cortknoxx-coder/DPA-AUP/ui-checks/device-toast.png

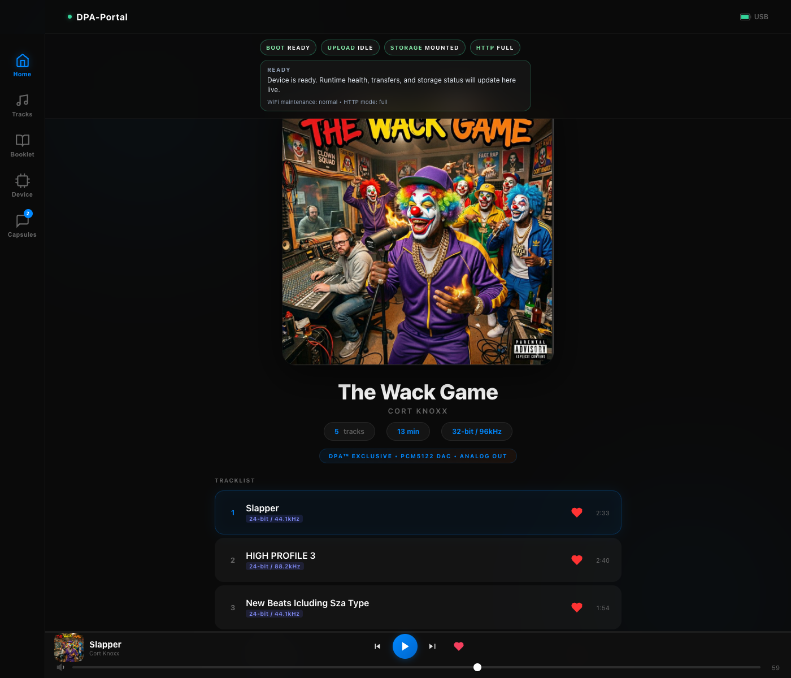
ui-checks/device-toast.png
