cortknoxx-coder/DPA-AUP/ui-checks/device-compact-hud.png

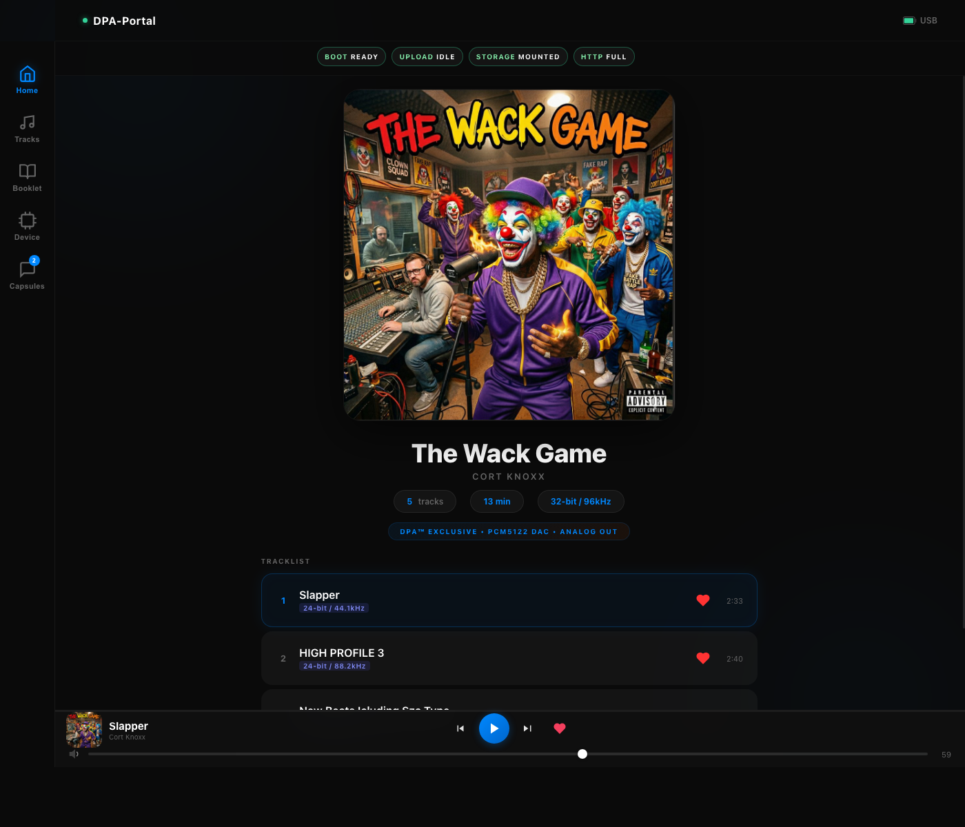
ui-checks/device-compact-hud.png
