cortknoxx-coder/DPA-AUP/ui-checks/creator-portal.png

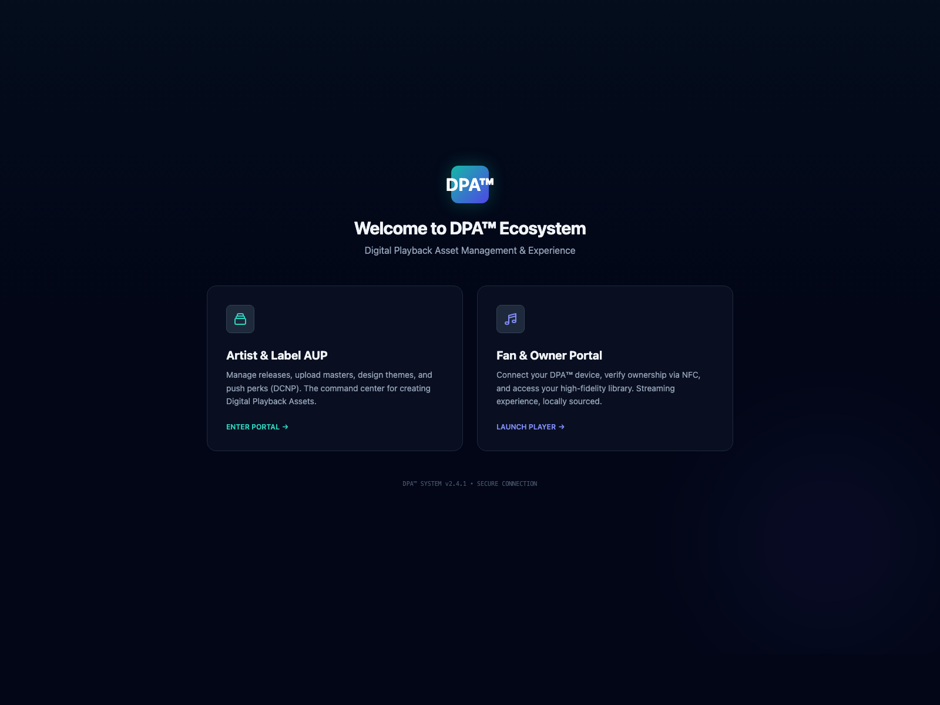
ui-checks/creator-portal.png
