cortknoxx-coder/DPA-AUP/ui-checks/creator-routed.png

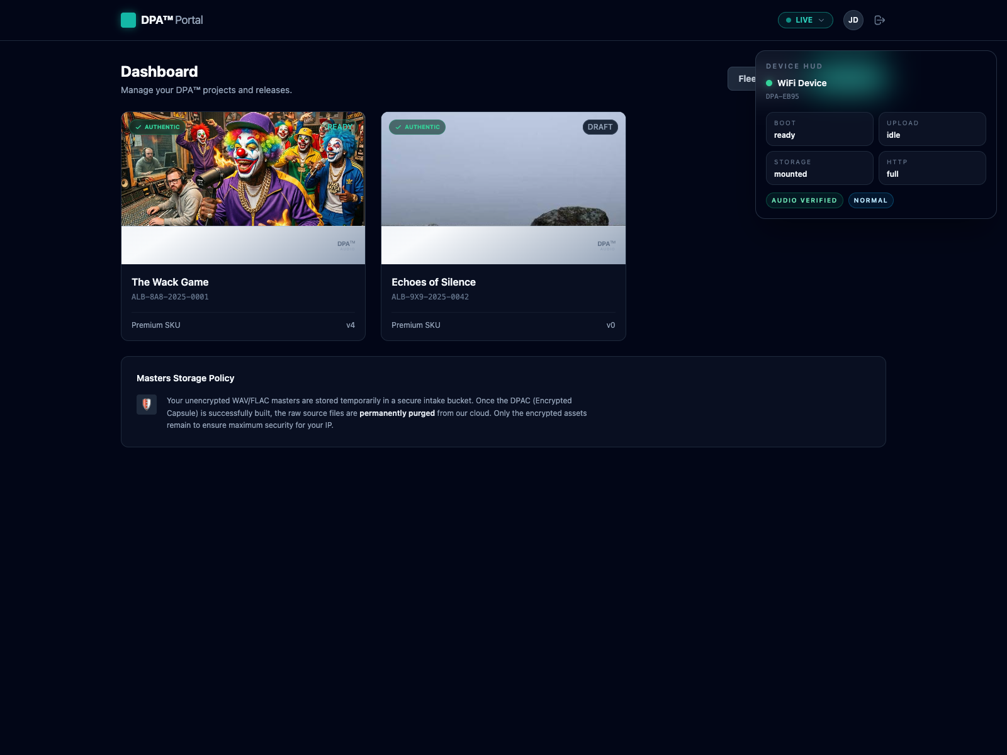
ui-checks/creator-routed.png
