cortknoxx-coder/DPA-AUP/ui-checks/device-dashboard.png

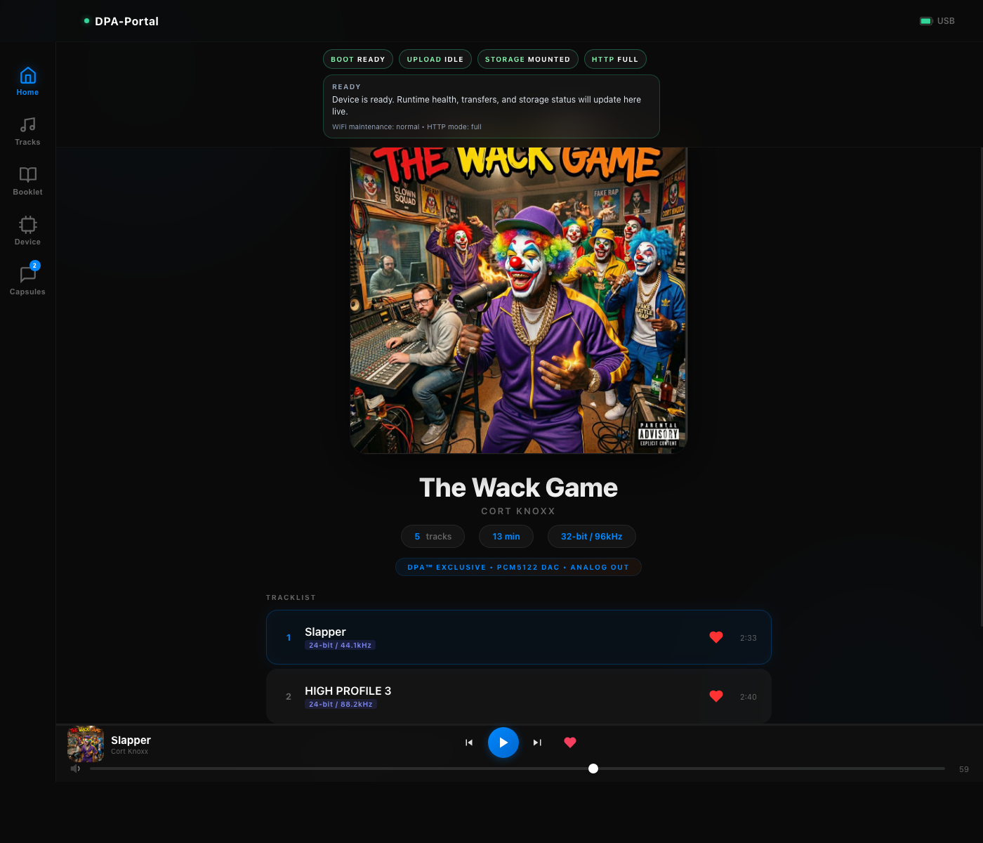
ui-checks/device-dashboard.png
