cortknoxx-coder/DPA-AUP/ui-checks/fan-routed.png

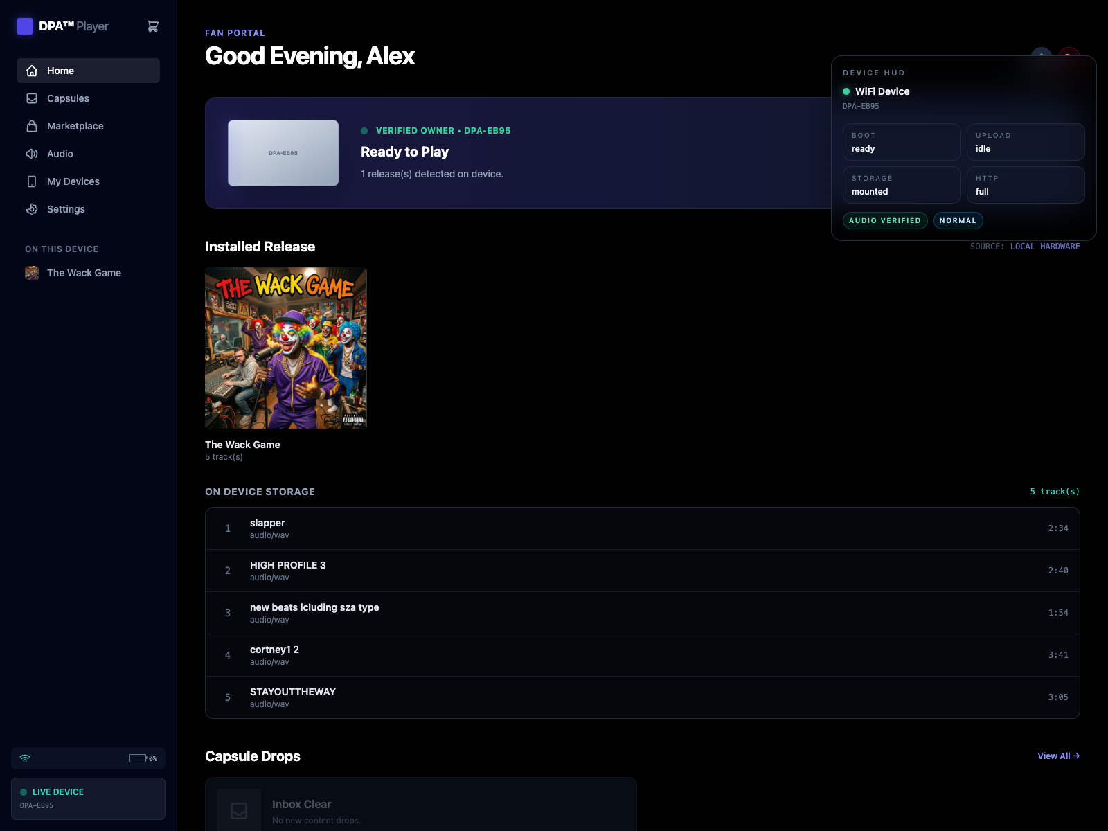
ui-checks/fan-routed.png
