cortknoxx-coder/DPA-AUP/(commit log)

2025-12-16 feat: Add visual animations and theme editor improvements
    Introduces CSS animations for visual flair and enhances the theme editor component.
    The dashboard now features animated vinyl graphics on album cards for a more engaging user experience. The theme editor has been updated to include a signal for `previewMode` and a computed property `currentPreviewStyle` to manage and display visualizer states. These changes lay the groundwork for interactive theme previews and visualizer controls.
2025-12-16 feat: Add d3, user admin, and upload functionality
    Introduces d3.js for potential future visualization features.
    Adds a User Admin route and basic UI structure to the application.
    Enhances the Track List component with file upload capabilities via drag-and-drop and file input.
    Includes initial styling for connection status display in the app component.
    Updates the Theme interface to support a `skinImage` property.
2025-12-16 feat: Restructure routes and improve navigation
    Introduces a new '/artist' route to group all artist-specific functionalities. This change separates the artist portal from future potential user-facing portals (e.g., fan portal).
    The root path now redirects to '/login', and the global navigation is conditionally hidden for login and fan portal routes.
    Updates are made to ensure all links correctly point to the new '/artist' nested routes.
2025-12-16 feat: Add fan portal routes and device connection UI
    Introduces new routes for the fan portal, including album detail, capsules, and device registration. Enhances the UI for displaying device connection status, now with inline text for better clarity on smaller screens. Also adds mock data generators for resale transactions and unit economics to `data.service.ts` and expands `DcnpEvent` and `DcnpPayload` types.
2025-12-17 feat: Add DPA device communication services
    Introduces core services for interacting with DPA devices, including:
    - `DeviceBridgeService`: Manages WebSocket communication with the local DPA bridge.
    - `CryptoService`: Handles AES-GCM decryption of data received from devices.
    - `DeviceConnectionService`: Manages device connection status and registration logic, now leveraging the `DeviceBridgeService`.
    - `PlayerService`: Enhanced to support encrypted playback by requesting session keys from the device via the bridge.
    New types are defined in `src/types.ts` to support device information, RPC requests/responses, and decryption key structures. `DPA_CONFIG` is added to manage service URLs.
2025-12-17 feat: Add marketplace listing data and UI
    Introduces mock data and type definitions for marketplace listings.
    Also includes CSS adjustments to hide number input spinners for a cleaner UI.
    Adds a new route for the fan portal marketplace and updates the main app component to manage the connection menu visibility.
2025-12-17 feat: Enhance device glow animation in theme editor
    Refines the CSS animations for the device's LED glow to create a more dynamic and visually appealing effect in the theme editor. Adjustments improve the breathing and pulsing animations for a smoother and more pronounced glow.
2025-12-19 feat: Update package name and Angular versions
    Updates the package name in `package.json` and `metadata.json` from "dpa-artist/fan-portal" to "dpa-creator/fan-portal" to better reflect its purpose.
    Also, upgrades Angular dependencies across `package.json` and `index.html` from v21.0.5 to v21.0.6 to incorporate the latest minor version updates and bug fixes.
    Minor adjustments were made to component templates and TypeScript files for improved code clarity and to fix minor rendering issues related to Tailwind CSS class formatting. The change in `index.html` regarding `<meta charset="utf-8" />` to `<meta charset="utf-t" />` appears to be a typo and has been corrected.
2025-12-19 feat: Add skin type to theme editor and fan checkout route
    Introduces a `skinType` property to the Theme interface, allowing for 'partial' or 'full' wrap options. The Theme Editor component is updated to include a UI for selecting this new skin type and adjusts the downloaded spec filename accordingly.
    Additionally, a new `FanCheckoutComponent` route is added to the fan portal. The device connection service now defaults to simulator mode for a smoother demo experience. Financials in the UserService are updated to include a `perksSource` and reflect more realistic simulated data. User Admin component revenue mix calculations are also updated.
2025-12-19 feat: Add fan settings page and routes
    Introduce a dedicated settings page for the fan portal, including navigation updates and route configuration. Also, move the `UserProfile` interface to a shared types file for better organization.
2025-12-19 feat: Add fleet tracker and DPA pricing details
    Introduce a new Fleet Tracker route and component.
    Add pricing information (retail price, manufacturing cost, currency) to album data and make it available for calculations.
    Update navigation and dashboard to include links to the new Fleet Tracker feature.
    Add DPA operator economics calculations to the Devices Dashboard component.
    Include D3 geo and geojson dependencies for potential future use.
2025-12-19 fix: Remove manufacturingCost from album pricing
    The `manufacturingCost` property was incorrectly placed within the `pricing` object of an album. It has been removed from this location as it is correctly defined within the `economics` object via the `generateEconomics()` function.
    Additionally, this commit includes minor routing adjustments for the fan portal to include an authentication step and updates UI elements related to authenticity and profit display.
2026-04-01 feat: Complete ESP32-S3 firmware Phase 3 — intelligence, mesh, audio-reactive LEDs, captive portal
    Implements all 4 priorities from the architecture extension plan:
    1. Captive Portal + Consumer/Admin Split (captive.h)
    - DNS hijack auto-opens dashboard on phone connect
    - Consumer-first UI, admin features gated behind DUID unlock or button combo
    2. On-Device Intelligence (intelligence.h)
    - Per-track analytics (play/skip counts, listen time, auto-rating)
    - Smart playlist engine (score-based ordering with recency penalty)
    - HMAC-SHA256 content binding via hardware acceleration
    - Playlist modes: normal, smart, smart_shuffle, repeat_one
    3. Audio-Reactive LEDs (audio_reactive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
    [api.h, audio.h, audio_reactive.h, captive.h, dpa-esp32.ino, espnow_mesh.h, intelligence.h]
2026-04-01 fix: Ship-blocker and reliability fixes from quality audit
    - Add deferred favorites save (g_favsDirty flag) to prevent SPI
    contention during playback, matching the analytics deferred pattern
    - Wire favoritesFlushIfDirty() into main loop alongside analytics flush
    - Fix ESP-NOW callback safety: defer play commands to main loop via
    volatile flags instead of calling playTrackByIndex() from WiFi context
    - Fix mesh self-message rejection before peer slot allocation
    - Fix analytics favoritedAt never being written (wire analyticsSyncFavorite)
    - Fix dual mode variable desync (g_playMode / g_playlistMode)
    - Remove dead favorites JSON system (~70 lines unused code)
    - Fix test tone portMAX_DELAY blo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
    [api.h, audio.h, dpa-esp32.ino, dpa_wifi.h, espnow_mesh.h, intelligence.h, sd_card.h]
2026-04-03 feat: New dashboard UI, LED pattern system, fan portal services, WiFi stability
    - Full dashboard rewrite with glass UI, tab navigation, lottie animations,
    track detail views, capsules, booklet, LED mirror, audio visualizer
    - LED pattern system: 29 patterns (base, animated, audio-reactive, VU meter)
    with proper type union in types.ts and optgroup dropdowns in theme editor
    - Fan portal: device-wifi, device-ble, device-nfc services; LED notification
    service; audio component; capsules interactivity; device preview component
    - Firmware: pushTheme payload flattened to match firmware API expectations;
    dashboard polling with fetchTimeout polyfill; browser caching for dashboard;
    pattern-cha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
    [api.h, audio.h, audio_reactive.h, captive.h, dpa-esp32.ino, espnow_mesh.h, intelligence.h]
2026-04-03 chore: Add docs, test firmware, audio test files, and backup configs
    - docs/: Hardware wiring guide, perfboard soldering guide, system architecture (MD + PDF)
    - firmware/dpa-button-test: Button test sketch
    - firmware/dpa-fan-sim: Fan simulator sketch
    - firmware/sd-test: SD card test sketch
    - firmware/test-audio: Test WAV files and SD card content templates
    - firmware/dpa-esp32 copy: Backup of firmware before major refactor
    - firmware/dpa-esp32/dashboard_old.html: Pre-rewrite dashboard reference
    - firmware/dpa-esp32/proxy.cjs: Dev proxy for dashboard testing
    - package-lock.json: Lock file for reproducible builds
2026-04-03 chore: Update .gitignore — exclude Angular cache, zip, and root dashboard.h stub
2026-04-03 feat: add PlatformIO build system for ESP32-S3 firmware
    - Add platformio.ini with pioarduino platform (Arduino Core 3.x + ESP-IDF 5.3)
    - Fix I2S struct init in audio.h for ESP-IDF 5.3 compatibility (designator order)
    - Pin FastLED to 3.9.12 (3.10.x has ESP-IDF 5.3 struct order bug in audio input)
    - Add src/ symlinks for PlatformIO project structure
    - Add .pio to .gitignore
    Build output:
    RAM: 44.7% (146,548 / 327,680 bytes)
    Flash: 94.3% (1,235,988 / 1,310,720 bytes)
    Build commands:
    pio run # compile
    pio run --target upload # flash via USB
    pio device monitor -b 115200 # serial monitor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
    [api.h, audio.h, audio_reactive.h, captive.h, dpa-esp32.ino, dpa_wifi.h, espnow_mesh.h]
2026-04-03 refactor: firmware audit — optimize for 96kHz/24-bit, remove dead code
    Audio engine (audio.h):
    - Fix test tone: 16-bit samples → 32-bit to match I2S config
    - Replace String() comparisons with memcmp() in WAV parser
    - Increase playback task stack 16KB → 20KB for 96kHz headroom
    - Right-size output buffer (64KB → 45KB) — saves 20KB RAM
    API (api.h):
    - Fix escJson: now escapes backslash, newlines, tabs, control chars
    - Remove dead /api/playlist/mode and /api/playlist/order endpoints
    - Remove verbose debug logging from /api/audio/play
    - Clean up /api/mode to only accept valid modes (normal, repeat_one)
    - Increase buildStatusJson reserve 1400 → 1800
    Intelligence (intelligence.h):
    - Re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
    [api.h, audio.h, dpa-esp32.ino, intelligence.h, led.h, sd_card.h]
2026-04-03 Add stop control to track detail player
2026-04-03 Fix fan home library artwork aspect ratio
2026-04-03 Wire creator theme push and fan album firmware flows
2026-04-03 Show live device tracks in fan devices page and route connect CTA to fan auth options
2026-04-03 fan: mirror My Devices LED controls to firmware state
2026-04-03 creator: enforce device-only dpa transfer pipeline
2026-04-03 Polish fan connection flow and clear stale errors
2026-04-04 Add close button to global player bar
2026-04-04 Fix device tracks visibility: show tracks on home page and handle firmware-only albums in detail view
2026-04-04 Wire NFC: tag read → WiFi auto-connect, tag write for provisioning, UI on My Devices
2026-04-04 Fix player bar: show track info, poll device for live progress, use device name for album title
2026-04-04 Add ™ to DPA branding across all portal pages
2026-04-04 Fix DPA upload indexing and reliable SD write path
    [api.h, dpa-esp32.ino]
2026-04-04 Switch upload to raw body streaming with 10-minute timeout for large DPA files
2026-04-04 Fix CORS preflight for uploads: handle OPTIONS in catch-all, add 10-min timeout
    [dpa-esp32.ino]
2026-04-04 Upload WAV directly to device instead of DPA-packaging in browser memory
2026-04-04 Sanitize upload filenames: replace spaces and special chars for FAT32 SD compatibility
    [api.h]
2026-04-04 Fix SD bus contention: disable WiFi sleep, pause background SPI tasks during upload
    [api.h, dpa-esp32.ino]
2026-04-04 Add synchronous upload server on port 81 — matches DPAC uploader pattern for reliable large files
2026-04-04 Stop async server during uploads to eliminate SPI bus contention with SD writes
2026-04-04 Total network isolation during upload: stop DNS+async server, dedicate loop to upload server, fix port rewrite
    [dpa-esp32.ino]
2026-04-04 Remove XHR timeout for uploads — large files over ESP32 AP WiFi need 30+ minutes
2026-04-05 Creator tracks: show device tracks when connected, add play button, fix player title sync
2026-04-05 Fix device dashboard: sync track title and index from firmware status when track changes
2026-04-05 Fix artist name (Cort Knoxx), add close button to expanded player, fix line-out distortion (WiFi sleep)
    [dpa-esp32.ino]
2026-04-05 Dashboard UX fixes + dynamic SSID + play bar heart: v2.4.0
    - Play bar: heart/favorite button, only art+info opens expanded view
    - Expanded player: bigger close button, tap-outside-to-close, stop button, TAP TO CLOSE hint
    - Heart state syncs in play bar from favorites
    - Dynamic SSID: Artist-Album-DPA from NVS metadata (32 char limit)
    - Theme push accepts artist/album fields for SSID update
    - Boot banner updated to v2.4.0
    - Dashboard cache disabled (no-cache, must-revalidate)
    [api.h, dpa-esp32.ino, dpa_wifi.h]
2026-04-05 Dashboard visual polish: signal chain badge, format badges on tracks, enhanced glow, play button pulse, now-playing highlight glow
2026-04-05 Visual polish pass 2: color-matched background per track, hero art transitions, visualizer bar glow, track accent colors
2026-04-06 Move play bar heart button to right of next button
2026-04-06 Fix LED ghosting: set brightness per frame, double-clear on init, prevent stale DMA data
    [led.h]
2026-04-06 Fix WiFi AP dropping clients: re-enable WiFi.setSleep(false) for connection stability
    [dpa_wifi.h]
2026-04-06 Fix stray LEDs at boot: force data pins LOW before init, triple-clear with brightness=0
    [dpa-esp32.ino, led.h]
2026-04-06 Fix play count persistence: flush analytics between tracks, add path to analytics JSON, save on complete
    [dpa-esp32.ino, intelligence.h]
2026-04-06 Wire Metadata tab: push artist/album to device on save, sets SSID via NVS, inline status feedback
2026-04-06 Wire Tracks tab: delete from device, add WiFi deleteFile method
2026-04-06 Wire Overview tab: show live device info (DUID, firmware version, storage, track count) when connected
2026-04-06 Add stop button to creator tracks tab alongside play button
2026-04-06 Creator tracks: add play counts column from device analytics, refresh track list after upload
2026-04-06 fix(portal): map analytics play counts by firmware track path
    Analytics payloads include per-track path; idx can diverge from
    scanned library order. Use path (and basename fallback) for creator
    Tracks tab and fan album popularity so counts match device JSON.
2026-04-06 Remove all mock/demo data (Midnight Horizons, 808 Dreams, etc.)
    - DataService: replaced hardcoded mock album, marketplace listings, DCNP
    events, booklet, lyrics, pricing, economics, and resales with clean
    empty starter project
    - UserService: zeroed profile, financials, earnings history, regions,
    top assets
    - FanMarketplaceComponent: emptied trade offers array
    - FleetService: replaced mock track names
    - CreateAlbumComponent: neutralised placeholder text
    - Bumped STORAGE_VERSION from 1→2 and renamed storage key so browsers
    automatically discard cached mock data on next load
    - Removed legacy 'dpa_mock_data' localStorage key on hydrate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
2026-04-06 Add FEATURE_WIRING_MAP.md — captures every mock data pathway and wiring status
    Documents all creator/fan portal features, their data sources, current
    wiring status (WIRED/EMPTY/STUB/NOT STARTED), and what needs real backend
    infrastructure. Serves as the implementation checklist going forward.
2026-04-06 Revert mock data removal — restore all demo content
    Brought back Midnight Horizons, 808 Dreams, marketplace listings,
    trade offers, user profile, financials, fleet track names, etc.
    Mock data stays as the working baseline. Features will be replaced
    with real data one at a time per FEATURE_WIRING_MAP.md.
    The album-layout redirect fix is kept as a safety net.
2026-04-06 Add cover art and per-track art upload
    Metadata tab:
    - New 'Cover Art' section with drag/hover upload, preview, remove
    - Uploads to device /art/cover.jpg when WiFi connected
    - Stored as base64 data URL in Album.artworkUrl (persists in localStorage)
    Tracks tab:
    - New 'Art' column with thumbnail per track row
    - Hover to upload, shows preview inline
    - Uploads to device /art/{trackId}.jpg when WiFi connected
    - Stored as base64 in Track.artworkUrl
    Types:
    - Added artworkUrl to Album interface
    - Added artworkUrl to Track interface
    - Added updateAlbumArtwork() and updateTrackArtwork() to DataService
    Dashboard card uses real artwork when available, falls back to picsum.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
2026-04-06 Add artwork upload tips and size recommendations
    Metadata tab cover art:
    - Bullet list: 3000x3000px, JPG/PNG, max 10MB, min 1400x1400 for
    distribution, sRGB color space tip
    - Note about where art appears (device, fan portal, marketplace)
    Tracks tab per-track art:
    - Column header tooltip with spec
    - Thumbnail tooltip with spec
    - Footer helper text under table with path info
2026-04-06 feat(firmware): /api/art SD artwork + dashboard loads real cover/track art
    ESP32:
    - GET /api/art?path=/art/cover.jpg (or .png/.webp) — serves files only
    under /art/; path traversal blocked; CORS + cache headers
    - Boot creates /art if missing
    - Dashboard: hero + booklet + track rows try /art/cover.{jpg,png} and
    per-track /art/{audioBasename}.{jpg,png,webp} with SVG fallbacks
    - Regenerated dashboard.h (run gen_dashboard.sh after dashboard edits)
    - Firmware v2.4.1
    Portal:
    - Per-track art upload names files from audio basename (matches device scanner)
    - Device track list merges saved artwork from local tracks when connected
    Docs: FEATURE_WIRING_MAP /api/art row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
    [api.h, dpa-esp32.ino]
2026-04-06 feat(creator): sync Theme & LED form from device when WiFi connected
    - On WiFi + opening theme tab: pull /api/status led + dcnp into form
    - Quiet persist merged theme via updateAlbumThemeQuiet (no needs-rebuild)
    - Poll every 5s while form pristine to pick up device/dashboard changes
    - Sync from device button + inline status when pulling manually
    - Stop polling on disconnect or destroy
2026-04-06 feat(theme): mirror firmware LED options, brightness, and gradient
    - Add shared FIRMWARE_LED_PATTERN_GROUPS (Basic, Animated, Audio, VU, Notification)
    - Extend Theme with ledBrightness and ledGradEnd aligned to NVS bright/grad_e
    - Theme editor: global brightness + VU gradient controls, live /api/led/preview
    - Default mock playback pattern matches firmware (vu_classic)
2026-04-06 refactor(theme): creator tab focuses on perk DCNP LED, not fan strip UI
    - Remove idle/playback/charging strip controls from creator theme form
    - Sync-from-device now pulls only dcnp colors; polls without overwriting strip
    - Save/push merge form with stored themeJson so album LED defaults still ship
    - Device mock preview uses DCNP colors and notification sequences only
2026-04-06 fix(theme): always show DPA mockup with perk LED glow preview
    - Remove connection gate so chassis + edge glow stay on Theme tab offline
    - Clarify copy: glow tied to DCNP/perk colors and notification preview
2026-04-06 fix(perks): shared capsuleId, mark delivered, flat POST body, richer firmware store, device reconciliation
    - capsuleId generated once and used as DcnpEvent.id + device push id
    - markDcnpEventDelivered() marks status after successful WiFi push
    - pushCapsule() now sends flat JSON (title/description/date/price/ctaLabel/ctaUrl/hasImage at top level)
    - videoUrl wired into video CTA payload
    - On WiFi connect, reconcile pending events against /api/capsules
    Firmware:
    - RuntimeCapsule extended with price, ctaLabel, ctaUrl, hasImage
    - POST /api/capsule parses flat keys reliably (no nested payload object)
    - GET /api/capsules returns extended fields
    - capsulesSave/Load handle new fields with es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
    [api.h]
2026-04-06 fix(firmware): forward-declare escJson before capsulesSave uses it
    [api.h]
2026-04-06 docs: add PROJECT_JOURNAL.md — full history, pain points, successes, learnings
2026-04-08 feat(firmware+portal): live metadata push, cover art pipeline, hero cover fallback
    Firmware (dpa-esp32):
    - api.h: expose artist/album/apSsid in /api/status
    - dpa_wifi.h: cache metadata globals, re-raise softAP live on SSID change
    - dpa-esp32.ino: port 81 upload handler honors ?path= param (audio upload
    optimization preserved — unchanged when param absent) + auto-mkdir parent
    - dashboard.html: read device metadata into hero/booklet/np UI,
    cache-bust cover art on meta change, album cover fallback chain,
    idempotent updateHeroCover() caching
    - dashboard.h: regenerated (gzipped)
    Portal (Angular):
    - angular.json + proxy.conf.json: dev proxy for /dpa-api (:80) and
    /dpa-upload (:81) — r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
2026-04-08 docs(hw): correct MCU to ESP32-S3 Zero + portal cover art source-of-truth
    Stale hardware references corrected to reflect actual production hardware
    (Waveshare ESP32-S3 Zero, 8MB flash, no PSRAM) which differs from the
    earlier WROVER-32 / WROOM-32 prototyping:
    - README.md: S3 Zero BOM, PlatformIO build steps, new flash workflow
    - docs/HARDWARE-WIRING.md: authoritative S3 Zero pin table pulled from
    firmware/dpa-esp32/dpa-esp32.ino #define block
    (SD: 10/11/12/13, I2S: 6/7/8, LED: 5, buttons: 1-4, ADC: 9, charge: 14)
    - docs/PERFBOARD-SOLDERING-GUIDE.md: legacy banner (WROVER-era, do not use)
    - docs/SYSTEM-ARCHITECTURE.md: MCU header corrected, legacy note added
    Portal cover art:
    - Downscal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
2026-04-08 fix(firmware): hero cover idempotency trap + cover replacement cache invalidation
    Two bugs were causing the firmware dashboard to not render the album
    cover even after /art/cover.jpg was successfully on SD:
    1) updateHeroCover() idempotency early-return trap:
    On first paint, tracks haven't loaded yet, so the "no track"
    branch rendered the LOADING SVG and cached __heroKey. When tracks
    loaded a moment later, trackIndex/artist/album were unchanged →
    idempotency short-circuited the re-mount forever.
    Fix: idempotency key now includes S.tracks.length + coverBytes,
    and the early-return has been removed — all paths flow through
    updateHeroCoverWithImageOrSvg() which has the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
    [api.h]
2026-04-08 fix(firmware): prevent boot hang on SD walker + harden FastLED against WiFi IRQ contention
    Two fixes forced by live device debugging today:
    1. sd_card.h: replace recursive dpaCountDirBytes() at boot with SD.usedBytes()
    (O(1) FAT metadata read). The walker was hanging the device at 400kHz
    immediately after SD mount — no serial output, no WiFi AP, LED stuck.
    Root cause: stray/pathological entries in SD root from earlier cover-art
    uploads, walker had no depth limit, no yield, no deadline. Walker itself
    is also hardened with depth cap, time budget, yield, and hidden-file skip
    so any future callers (sdRefreshStats, sdListFilesJson) are safe too.
    2. led.h: add FASTLED_ALLOW_I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
    [led.h, sd_card.h]
2026-04-09 feat: auto-extract cover art colors for LED playback theme + white breathing idle default
    Portal now analyzes cover art on upload using canvas pixel sampling to extract
    the two most dominant vibrant colors, then pushes them to the device as the
    playback LED theme (play_color + gradEnd). The VU/beat-detect patterns
    automatically use the album's colors so the light show matches the artwork.
    - Added extractDominantColors() to album-metadata component — quantizes to
    64×64, clusters vibrant pixels by HSV saturation/brightness, picks top 2
    with sufficient visual contrast
    - After verified cover upload, auto-pushes theme via POST /api/theme
    - Fixed variable shadowing bug (loop var `b` shadow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
    [dpa-esp32.ino]
2026-04-09 feat: auto-sync LED colors from device cover art on WiFi connect
    When the portal connects to the DPA over WiFi, it now automatically:
    1. Checks if cover art exists on the device SD card
    2. Fetches the image and extracts the 2 most dominant vibrant colors
    3. Pushes them as the playback LED theme (play_color + gradEnd)
    This runs from the device-connection service (any page, not just
    album-metadata) so the lights always match the album artwork the
    moment the fan joins the SSID.
    - Added syncLedColorsFromCover() + extractCoverColors() to
    DeviceConnectionService — fires on every successful WiFi connect
    - Album-metadata component still does the same on its page load
    (defense in depth) and o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
2026-04-09 fix(firmware): stop re-enabling WiFi sleep after uploads — prevents AP client drops
    After every file upload (audio or cover art), the sync upload handler was
    calling WiFi.setSleep(true) to "reduce DAC power rail noise". This put the
    AP radio into power-save mode, causing intermittent client disconnects that
    the portal couldn't detect (showed "connected" while WiFi was actually
    dropping).
    wifiInit() already sets WIFI_PS_NONE + WiFi.setSleep(false) specifically
    for AP stability. Removed the two post-upload setSleep(true) calls so the
    AP stays rock-solid for the entire session.
    [dpa-esp32.ino]
2026-04-09 fix(firmware): heap watchdog + throttle feature polling to prevent socket exhaustion
    The ESP32's AsyncWebServer has ~4 concurrent sockets. When the dashboard
    (2s status poll + 250ms feature poll) AND the portal (its own status poll)
    are both open, sockets pile up faster than they close. After minutes the
    server stops responding while WiFi AP stays up — "connected but dead."
    Fixes:
    1. Heap watchdog in loop(): every 10s checks ESP.getFreeHeap(); if below
    40KB (sign of stuck sockets), restarts the async server to reclaim them.
    2. Throttled dashboard feature poll from 250ms to 500ms during playback.
    Still responsive enough for VU meters, halves the socket pressure.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
    [dpa-esp32.ino]
2026-04-09 perf: custom 4MB partition + remove 7 unused LED patterns (99.3% → 31.5% flash)
    The default partition table allocated only 1.25MB for the app on an 8MB
    flash chip — we were at 99.3% usage with 9KB headroom. Created a custom
    partition that gives the app 4MB by removing the unused OTA slot + SPIFFS.
    Also removed 7 LED patterns to further shrink firmware:
    - VU playback: vu_fill, vu_peak, vu_split, vu_bass, vu_energy
    (vu_classic remains as the single audio-reactive pattern)
    - Idle: dual_comet, meteor
    - Removed corresponding UI cards from dashboard
    Result: 1,299,344 / 4,128,768 bytes = 31.5% flash used, 2.7MB free.
    [partitions.csv]
2026-04-09 docs: rewrite QUICKSTART for Linux + macOS with full setup guide
    Adds complete one-time Linux setup (PlatformIO, Node, udev rules for
    ESP32-S3 native USB CDC), daily dev workflow, macOS section, and
    troubleshooting table.
    https://claude.ai/code/session_01QbZnLQCvUSbkvWTvau2fPB
2026-04-09 refactor(firmware): migrate WiFi + SD card from Arduino wrappers to ESP-IDF native
    Replace Arduino WiFi.h with esp_wifi/esp_netif/esp_event for event-driven
    WiFi management. Replace Arduino SD.h/SPI.h with esp_vfs_fat_sdspi_mount
    + POSIX file I/O (fopen/fread/fwrite/opendir/readdir). SD speed switching
    now uses sdspi_host_set_card_clk() — no unmount/remount needed.
    All 9 firmware source files updated:
    - dpa_wifi.h: full ESP-IDF rewrite (event handler, esp_netif, WIFI_PS_NONE)
    - sd_card.h: ESP-IDF SDSPI mount + VFS + POSIX helpers (sdPath, sdFopen, etc.)
    - dpa_format.h: File& → FILE* for WAV/DPA header parsing
    - audio.h: FILE* for playback streaming, opendir/readdir for track scanning
    -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
    [api.h, audio.h, captive.h, dpa-esp32.ino, dpa_format.h, dpa_wifi.h, espnow_mesh.h, intelligence.h]
2026-04-09 feat(firmware): genre LED presets, snappy track tapping, dashboard polish
    - Replace basic idle LED patterns with 9 genre-themed rainbow presets
    (Rock, Hip-Hop, R&B, EDM, Soul, Pop, Metal, Chill) using hue-range
    rainbow in firmware — each genre sweeps through authentic color pairs
    - Add genre VU presets for playback (beat-reactive with genre colors)
    - Remove confusing End Color picker — genres handle colors automatically
    - Fix browser refresh hang: overlay stays until first successful poll
    - Fix fan portal link: default to 192.168.4.1 instead of localhost:4200
    - Add active button feedback (border glow + white text) on genre cards
    - Optimize track tapping: instant CSS touch feedback (s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
    [api.h, audio.h, captive.h, dpa-esp32.ino, dpa_format.h, dpa_wifi.h, espnow_mesh.h]
2026-04-09 feat(portal): auto-detect device WiFi + sync real data from device
    - Auto-probe device on fan-auth page load — skip manual connect
    when already on DPA WiFi network (shows "Searching..." spinner)
    - Pull real artist/album name from device /api/status into portal
    (no more mock "808 Dreams" / "Midnight Horizons" when connected)
    - Use device cover art (/art/cover.jpg) instead of picsum.photos
    placeholder for library artwork
    - Add syncAlbumFromDevice() to DataService — updates album metadata
    and track list from device without triggering rebuild status
    - Wire connectViaWifi() to push device tracks + metadata into
    DataService so all portal components get real data automatically
    - Add a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
2026-04-10 fix(portal): harden device connection flows and checkpoint docs
    Reduce live AP/proxy request thrash, improve creator auto-detection, and capture the validated April 10 checkpoint across firmware and portal docs.
    Made-with: Cursor
    [api.h, audio.h, dpa-esp32.ino, sd_card.h]
2026-04-11 chore(dev): wire internal ingest proxy setup
    Add the local ingest server command and proxy/gitignore updates so the internal ingest flow can run from the repo with the requested checkpointed artifacts.
    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
2026-04-12 feat(portal): add hosted device sync and ingest workflows
    Wire the portal and firmware for hosted device access, private ingest, and capsule OTA delivery. This also hardens hosted upload progress and verification so Vercel-based transfers can complete against the live device more reliably.
    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
    [partitions.csv]
2026-04-12 feat(portal): gate creator and fan flows behind device auth
    Require a confirmed device connection before either portal reveals its dashboard surfaces. This also hardens WiFi detection retries and adds the local relay tooling used to keep hosted and local device sync aligned.
    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
2026-04-12 feat(portal): encode the DPA connection matrix in the gate flow
    Make the creator and fan gate screens explain the product's device-authenticated connection modes and surface the active transport context. This keeps the portal blocked until a live DPA is reachable while clarifying DPA SSID, same-LAN, and remote-only behavior.
    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
2026-04-13 fix(audio): overhaul PCM5122 playback pipeline for glitch-free audio
    - Enable APLL for precise I2S clock generation (was using imprecise default PLL)
    - Fix output buffer overflow in audioConvertToStereo32 — 16-bit stereo input
    exceeded the 11264-entry output buffer, corrupting memory during playback
    - Increase DMA buffers: 49KB at 44.1kHz (139ms), 73KB at 88.2/96kHz (96ms)
    - Raise audio task priority to configMAX_PRIORITIES-2 on core 1
    - Rate-limit FastLED.show() to 30fps during playback (was ~200fps), reducing
    interrupt-blocked time from ~10% to ~1.5% of wall time
    - Block all control plane restarts (heap watchdog, AP recovery, portal
    inactivity) during active audio playbac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
    [api.h, audio.h, dpa-esp32.ino, dpa_ingest.h, led.h]
2026-04-13 feat(portal+firmware): upload/delete stability, DPA1 v2 header, cover art fix
    - Extend DPA1 header to v2 (524 bytes) with artist, album, ISRC, genre,
    record label, and copyright fields (firmware + portal)
    - Zero-copy Blob upload: prepend DPA1 header to WAV without reading full
    file into memory, supporting uploads up to 200MB
    - Add firmware upload progress reporting (uploadBytesWritten/Expected in
    /api/status) and portal cross-origin progress monitor polling port 80
    instead of busy port 81
    - Add GET alias for /api/sd/delete on both ports (80 + 81) to bypass
    CORS preflight blocking from Vercel HTTPS portal
    - Optimistic delete UI: track removed from list immediately, then
    confirmed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
    [api.h, dpa-esp32.ino, dpa_format.h]
2026-04-13 fix(portal+firmware): heap optimization, track reorder, metadata save cover stability
    Firmware heap optimization:
    - Reduce I2S DMA buffer sizing (saves 25-41KB during playback)
    - Static reusable String buffer for buildStatusJson (reserve 4500)
    - Free track JSON cache when playback starts
    - Guard /api/playlist/order with apiRejectHeavyRequest
    - Static playlist reorder scratch arrays (prevent stack overflow)
    - Stream-parse capsules.json instead of loading entire file into String
    Track reorder + release build:
    - Drag-and-drop track reordering with /api/playlist/order endpoints
    - Playlist order persistence via /data/playlist.txt on SD
    - Mirror theme/playlist endpoints on port 81 for cross-origi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
    [api.h, audio.h, dpa-esp32.ino]
2026-04-14 feat(cloud): DPA Vercel Cloud Phase 2 — live analytics, fleet dashboard, Edge Config, cron jobs
    Wire portal analytics relay to cloud (60s interval + check-in on connect),
    rewrite fleet tracker with live KPIs/device table/top tracks from Neon Postgres,
    add Edge Config for feature flags and firmware pointer, create fleet-health
    (every 5min) and analytics-rollup (daily) cron jobs, enhance Edge Middleware
    with admin gate, maintenance mode, geo headers, and portal announcements.
    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
2026-04-14 docs: comprehensive update of all stale documentation for Phase 4.5
    - README: add Vercel cloud backend section, cloud services, updated tech stack,
    project status through Phase 4.5, correct TypeScript version, add api/ tree
    - AGENTS.md: add cloud backend as third major part, Phase 4.5 status, Vercel
    file map, cloud API endpoints, updated services list, new dev commands
    - FEATURE_WIRING_MAP: fleet tracker STUB→WIRED (cloud-backed), add track
    reorder and release build features, add cloud-backed features table
    - SYSTEM-ARCHITECTURE: add full Vercel Cloud Backend section (services, API
    routes, cron jobs, edge middleware, analytics pipeline), update services table
    - DPA_PORTAL_FIRMWARE_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
2026-04-25 feat(firmware): DPA DSP engine, new EQ presets, stereo width, dashboard refresh
    Audio pipeline upgrade
    - Replace 3-band biquad EQ with multi-stage DSP chain: preamp -> HPF
    cleanup -> tone filters -> bass enhancement -> stereo widening ->
    threshold-aware soft limiter -> safety clamp
    - Coefficients regenerated per track at native sample rate so DPA1
    playback stays intact
    - New presets: dpa_signature, hip_hop, pop, vocal, custom (replaces
    bass_boost, warm)
    - Smoothed control parameters (preamp, width, master gain, output trim)
    to avoid zipper noise during preset switches
    - DSP telemetry exposed via /api/audio/output-gain (peak pre/post
    limiter, reduction dB, limiter events, master c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
    [api.h, audio.h, audio_reactive.h, dpa-esp32.ino, dpa_wifi.h, led.h]
2026-04-25 feat(portal): align with firmware DSP, new device presentation signals
    Type system
    - EqPreset updated to firmware canonical values: flat, dpa_signature,
    hip_hop, pop, vocal, custom (drops bass/bass_boost/warm aliases)
    - New AudioWidthMode type (off | enhanced)
    - New presentation interfaces: DeviceAudioPresentation,
    DeviceLedModePresentation, DeviceThemePresentation,
    ConnectedAlbumPresentation
    - BatteryStatus.present optional field for USB-powered detection
    Device WiFi service
    - setStereoWidth(mode) calls /api/audio/stereo-width
    - setEqPreset sends preset directly (no more bass -> bass_boost remap)
    - audioPresentation() and themePresentation() helpers normalize live
    status into UI-re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
